youenc120-ux/smart-iv-drip-alert/SmartIVDrip.ino

/*
 * 智慧點滴注射預警系統 (Smart IV Drip Alert System)
 * 平台：ESP32 (Arduino core 3.x)
 *
 * 功能：
 *   - 上、下兩組非接觸式紅外線液位感測器，雙階段判斷
 *   - 第一階段（液位低於上位）：警示燈恆亮 + 提示音 + 推播
 *   - 第二階段（液位低於下位）：警示燈快閃 + 每秒警報 + 推播
 *   - 感測器狀態矛盾（上有液、下無液）判為感測器異常
 *   - 手機網頁即時監控（每秒更新）、遠端靜音、預估剩餘時間、更換紀錄
 *   - 網頁設定頁：床位名稱、Wi-Fi、網址、配對碼、點滴參數（免重新燒錄）
 *   - 固定網址：http://<裝置名稱>.local（mDNS）
 *   - 無線更新（OTA），密碼在 secrets.h 的 OTA_PASS：
 *       1. 網頁更新：瀏覽器開 http://<裝置>.local/update（帳號 admin），上傳編譯好的 .bin
 *       2. Arduino IDE「連接埠」選網路裝置（需允許防火牆，學校網路可能被擋）
 *   - 網頁推播：ESP32 直接加密並送到 Apple / Google 推播服務，不經第三方通知平台
 *
 * 接線：
 *   上位 TCRT5000 模組 AO -> GPIO32（VCC 接 3V3，DO 不接）
 *   下位 TCRT5000 模組 AO -> GPIO33（VCC 接 3V3，DO 不接）
 *     讀類比值，在設定頁「感測器校正」記錄有液 / 無液的讀值
 *   蜂鳴器模組 I/O -> GPIO25（VCC 接 3V3 或 5V，依模組規格）
 *   WS2812B 8 燈燈條 DIN -> 330Ω -> GPIO26（5V 接 VIN）
 *     第 1 顆：Wi-Fi 狀態；第 2–8 顆：液量燈條
 *
 * 需要程式庫：Adafruit NeoPixel（Arduino IDE 程式庫管理員搜尋安裝）
 */

#include <WiFi.h>
#include <WebServer.h>
#include <HTTPClient.h>
#include <WiFiClientSecure.h>
#include <ESPmDNS.h>
#include <ArduinoOTA.h>
#include <HTTPUpdateServer.h>
#include <Adafruit_NeoPixel.h>
#include <Preferences.h>
#include <time.h>
#include <vector>
#include "webpush.h"
#include "index_html.h"
#include "pair_html.h"
#include "settings_html.h"

// ===== 使用者設定 =====
// Wi-Fi 密碼與推播金鑰放在 secrets.h（不會上傳 GitHub）
// 第一次使用：把 secrets.example.h 複製一份改名為 secrets.h 再填入，並執行 make_vapid.ps1
// 之後床位名稱、Wi-Fi 等都可以在 http://<裝置>/settings 修改
#include "secrets.h"

const char* AP_SSID       = "IV-Monitor";  // 連不上 Wi-Fi 時自建熱點
const char* VAPID_SUBJECT = "https://github.com/youenc120-ux/smart-iv-drip-alert";  // 推播服務出問題時的聯絡方式

const unsigned long REPEAT_EMPTY_MS = 2UL * 60 * 1000;  // 第二階段未處理時每 2 分鐘再推播
const size_t MAX_SUBS    = 10;                           // 最多綁定幾支手機
const size_t MAX_HISTORY = 20;                           // 保留幾筆更換紀錄

// 感測器接 TCRT5000 模組的 AO（類比輸出），反射越強讀值越低。
// 有液 / 無液的讀值在設定頁「感測器校正」記錄；尚未校正時，暫時以中間值 2048 判斷，
// 並假設有液體時讀值較低（LIQUID_LEVEL = LOW）。
const int LIQUID_LEVEL = LOW;
const int MIN_CAL_GAP  = 150;  // 有液 / 無液讀值差距小於這個值，就提醒調整位置
const int MIN_TOUCH_GAP = 30;  // 鋁箔觸控模式的最小差距（實測後再調整）

const int PIN_SENSOR_UPPER = 32;
const int PIN_SENSOR_LOWER = 33;
const int PIN_BUZZER       = 25;
const int PIN_PIXELS       = 26;

// 蜂鳴器：HW-508 是被動式，要送 2–4kHz 方波才會發出清楚的聲音
// 換成主動式模組（通電就響）時改成 false，並依模組設定 BUZZER_ON（低電位觸發 = LOW）
const bool BUZZER_PASSIVE = true;
const int BUZZER_ON = LOW;

// WS2812B 燈條：第 0 顆顯示 Wi-Fi，其餘當液量燈條
const int NUM_PIXELS     = 8;
const int LED_BRIGHTNESS = 40;  // 0–255；8 顆全亮時電流不小，展示用 40 就夠亮
Adafruit_NeoPixel pixels(NUM_PIXELS, PIN_PIXELS, NEO_GRB + NEO_KHZ800);

const unsigned long DEBOUNCE_MS   = 1500;            // 液面晃動 / 氣泡濾除
const unsigned long MUTE_STAGE1_MS = 5UL * 60 * 1000; // 第一階段靜音 5 分鐘
const unsigned long MUTE_STAGE2_MS = 60UL * 1000;     // 第二階段最多靜音 1 分鐘

// ===== 狀態 =====
enum DripState { NORMAL, LOW_LEVEL, EMPTY, SENSOR_FAULT };
const char* STATE_KEY[]   = { "normal", "low", "empty", "fault" };
const char* STATE_TEXT[]  = { "液量充足", "第一階段：液量偏低", "第二階段：請立即更換", "感測器異常" };
const char* STATE_EMOJI[] = { "✅", "⚠️", "🚨", "❗" };

WebServer server(80);
HTTPUpdateServer httpUpdater;

DripState state = NORMAL;
unsigned long stateSince = 0;
unsigned long mutedUntil = 0;
bool apMode = false;
bool otaRunning = false;      // 無線更新中：暫停警報輸出
unsigned long restartAt = 0;  // 設定變更後延遲重新開機

// 型別需在第一個函式前定義，Arduino 自動產生的函式宣告才找得到

// 可在網頁上修改的設定（存在快閃記憶體）
struct Config {
  String bed = "301 病房 A 床";
  String host = "iv-monitor";  // 固定網址 http://iv-monitor.local
  String ssid, pass;           // 空白 = 使用 secrets.h
  String pin;                  // 配對碼，空白 = 不需要
  int mlBetween = 100;         // 上位到下位之間的液量（ml）
  int mlBelow = 50;            // 下位以下的剩餘液量（ml）
  int rateMlH = 0;             // 醫囑滴速（ml/小時），0 = 未設定
  // 感測器校正值（TCRT5000 的 AO 類比讀值 0–4095），-1 = 尚未校正
  int wetU = -1, dryU = -1;    // 上位：有液體 / 沒液體時的讀值
  int wetL = -1, dryL = -1;    // 下位：有液體 / 沒液體時的讀值
  // 感測方式：0 = TCRT5000 類比，1 = 相機節點（ESP32-CAM 回報液位百分比）
  int sensorMode = 0;          // 2 = 鋁箔觸控（GPIO32/33 是觸控腳位 T9/T8）
  String camHost = "iv-cam";   // 相機位址：主機名稱（不含 .local）或 IP
  int camUpper = 60;           // 液位低於這個百分比 = 上位沒液體（第一階段）
  int camLower = 20;           // 液位低於這個百分比 = 下位沒液體（第二階段）
} cfg;

// 去彈跳
struct Debounced {
  int pin;
  bool stable;        // true = 偵測到液體
  bool lastRaw;
  unsigned long changedAt;
};
Debounced upper = { PIN_SENSOR_UPPER, true, true, 0 };
Debounced lower = { PIN_SENSOR_LOWER, true, true, 0 };

// 推播訊息；welcome = 只送給剛綁定的手機（welcomeEndpoint 空白 = 全部手機）的測試通知
struct Notice { uint8_t state; char body[200]; bool welcome; };

// 一袋點滴的紀錄（Unix 秒，0 = 沒有發生或時間未知）
struct BagRecord { uint32_t startAt, lowAt, emptyAt, ackAt, doneAt; };

// 已綁定的手機（網頁伺服器與推播工作都會用到，以互斥鎖保護）
std::vector<webpush::Subscription> subs;
SemaphoreHandle_t subsLock;
String welcomeEndpoint;
Preferences prefs;
uint8_t vapidPriv[32];
bool vapidReady = false;

// 更換紀錄與滴速
BagRecord history[MAX_HISTORY];
size_t historyCount = 0;
BagRecord cur = { 0, 0, 0, 0, 0 };
uint32_t lastDoneAt = 0;          // 上一袋更換完成的時間 = 這一袋開始
unsigned long lowEnteredMs = 0;   // 進入第一階段的 millis，用來實測滴速
float bagRate = 0;                // 這一袋實測滴速（ml/小時）
float lastRate = 0;               // 上一袋實測滴速

// 配對碼嘗試次數限制
int pinFails = 0;
unsigned long pinLockUntil = 0;

// ===== 感測器（類比讀值 / 鋁箔觸控 + 校正）=====
// sensorMode 0：TCRT5000 的 AO 類比值（0–4095）
// sensorMode 2：鋁箔貼在點滴袋外，接 ESP32 觸控腳位；有水時電容變大，觸控讀值變小
//               （Arduino core 3.x 的 touchRead 數值較大，取 0–8000）
int rawU = 0, rawL = 0;  // 平滑後的讀值

bool touchMode() { return cfg.sensorMode == 2; }
int sensorMax() { return touchMode() ? 8000 : 4095; }
int minGap() { return touchMode() ? MIN_TOUCH_GAP : MIN_CAL_GAP; }

int readSensor(int pin) {
  long sum = 0;
  if (touchMode()) {
    for (int i = 0; i < 4; i++) sum += touchRead(pin);
    return min((long)sensorMax(), sum / 4);
  }
  for (int i = 0; i < 16; i++) sum += analogRead(pin);
  return sum / 16;
}

// 每 20ms 取樣一次，指數平滑濾掉雜訊
void sampleSensors(unsigned long now, bool force = false) {
  static unsigned long last = 0;
  if (!force && now - last < 20) return;
  last = now;
  int u = readSensor(PIN_SENSOR_UPPER), l = readSensor(PIN_SENSOR_LOWER);
  rawU = force ? u : (rawU * 3 + u) / 4;
  rawL = force ? l : (rawL * 3 + l) / 4;
}

// 依校正值判斷有沒有液體；中點加上遲滯，避免讀值在邊界附近時跳來跳去
bool judgeLiquid(int raw, int wet, int dry, bool prev) {
  if (wet < 0 || dry < 0) {  // 尚未校正：觸控模式有水時讀值較小；類比模式依 LIQUID_LEVEL
    wet = touchMode() || LIQUID_LEVEL == LOW ? 0 : sensorMax();
    dry = sensorMax() - wet;
  }
  int mid = (wet + dry) / 2, hys = abs(wet - dry) / 10;
  bool wetLow = wet < dry;
  if (prev) return wetLow ? raw < mid + hys : raw > mid - hys;
  return wetLow ? raw < mid - hys : raw > mid + hys;
}

// 相機節點回報的液位（由 camTask 更新）
volatile int camLevel = -1;
volatile unsigned long camOkAt = 0;

bool camFresh() { return camOkAt && millis() - camOkAt < 10000; }

bool readLiquid(const Debounced& s) {
  if (cfg.sensorMode == 1) {
    if (!camFresh()) {
      // 開機 30 秒內相機可能還沒連上，先當作正常；之後仍沒有資料 = 上有液、下無液 → 感測器異常
      return millis() < 30000 || s.pin == PIN_SENSOR_UPPER;
    }
    int thr = s.pin == PIN_SENSOR_UPPER ? cfg.camUpper : cfg.camLower;
    return s.lastRaw ? camLevel >= thr - 2 : camLevel >= thr;  // 2% 遲滯，避免在門檻附近跳動
  }
  return s.pin == PIN_SENSOR_UPPER ? judgeLiquid(rawU, cfg.wetU, cfg.dryU, s.lastRaw)
                                   : judgeLiquid(rawL, cfg.wetL, cfg.dryL, s.lastRaw);
}

void updateDebounce(Debounced& s, unsigned long now) {
  bool raw = readLiquid(s);
  if (raw != s.lastRaw) { s.lastRaw = raw; s.changedAt = now; }
  if (raw != s.stable && now - s.changedAt >= DEBOUNCE_MS) s.stable = raw;
}

DripState evaluate() {
  if (upper.stable && lower.stable)   return NORMAL;
  if (!upper.stable && lower.stable)  return LOW_LEVEL;
  if (!upper.stable && !lower.stable) return EMPTY;
  return SENSOR_FAULT;  // 上有液、下無液：物理上不合理
}

uint32_t nowEpoch() {
  time_t t = time(nullptr);
  return t >= 1700000000 ? (uint32_t)t : 0;
}

// ===== 輸出（燈條 / 蜂鳴器），非阻塞 =====
// 燈條：第 0 顆 = Wi-Fi（青＝已連線、藍＝熱點模式、白色閃＝斷線重連中）
//       第 1–7 顆 = 液量：充足 7 顆綠、偏低 4 顆黃、耗盡 2 顆紅快閃、異常全部紫色慢閃
// 靜音時改為恆亮不閃，現場一看就知道「已有人處理」
void updatePixels(unsigned long now, bool muted) {
  static uint32_t lastFrame[NUM_PIXELS];
  uint32_t frame[NUM_PIXELS];
  const int bar = NUM_PIXELS - 1;

  bool wifiOk = apMode || WiFi.status() == WL_CONNECTED;
  frame[0] = apMode ? pixels.Color(0, 0, 255)
           : wifiOk ? pixels.Color(0, 200, 200)
           : ((now / 400) % 2 ? pixels.Color(160, 160, 160) : 0);

  uint32_t color = 0;
  int lit = 0;
  bool blink = false;
  switch (state) {
    case NORMAL:       color = pixels.Color(0, 220, 0);   lit = bar;           break;
    case LOW_LEVEL:    color = pixels.Color(255, 140, 0); lit = (bar + 1) / 2; break;
    case EMPTY:        color = pixels.Color(255, 0, 0);   lit = 2; blink = (now / 250) % 2;  break;
    case SENSOR_FAULT: color = pixels.Color(150, 0, 255); lit = bar; blink = (now / 1000) % 2; break;
  }
  if (muted) blink = false;
  for (int i = 0; i < bar; i++) frame[i + 1] = (i < lit && !blink) ? color : 0;

  // 有變化才更新，避免頻繁送資料造成閃爍
  if (memcmp(frame, lastFrame, sizeof(frame)) == 0) return;
  memcpy(lastFrame, frame, sizeof(frame));
  for (int i = 0; i < NUM_PIXELS; i++) pixels.setPixelColor(i, frame[i]);
  pixels.show();
}

// 設定蜂鳴器頻率，0 = 安靜。只有改變時才動作
void setBuzzer(uint32_t freq) {
  static uint32_t current = UINT32_MAX;
  static bool attached = false;
  if (freq == current) return;
  current = freq;

  if (!BUZZER_PASSIVE) {
    digitalWrite(PIN_BUZZER, freq ? BUZZER_ON : !BUZZER_ON);
    return;
  }
  if (freq) {
    if (!attached) attached = ledcAttach(PIN_BUZZER, freq, 8);
    if (attached) ledcWriteTone(PIN_BUZZER, freq);  // 50% 方波
  } else {
    if (attached) { ledcDetach(PIN_BUZZER); attached = false; }
    pinMode(PIN_BUZZER, OUTPUT);
    digitalWrite(PIN_BUZZER, LOW);  // 安靜時保持低電位，蜂鳴器不通電
  }
}

void updateOutputs(unsigned long now) {
  bool muted = now < mutedUntil;
  unsigned long t = now - stateSince;
  uint32_t freq = 0;

  updatePixels(now, muted);

  switch (state) {
    case LOW_LEVEL: {
      // 「嗶、嗶」兩聲：進入時一次，之後每 30 秒提醒一次
      unsigned long c = t % 30000;
      if (c < 150 || (c >= 250 && c < 400)) freq = 2400;
      break;
    }
    case EMPTY: {
      // 每秒前 0.6 秒高低音交替（像救護車），連續警報
      unsigned long c = t % 1000;
      if (c < 600) freq = (c / 150) % 2 ? 2000 : 2700;
      break;
    }
    case SENSOR_FAULT:
      if (t % 3000 < 120) freq = 1500;  // 低沉短音，和液位警報區分
      break;
    default: break;
  }
  setBuzzer(muted ? 0 : freq);
}

String jsonEscape(const char* s) {
  String out;
  for (; *s; s++) {
    if (*s == '"' || *s == '\\') { out += '\\'; out += *s; }
    else if (*s == '\n') out += "\\n";
    else if ((uint8_t)*s >= 0x20) out += *s;
  }
  return out;
}
String jsonEscape(const String& s) { return jsonEscape(s.c_str()); }

// ===== 設定 =====
void loadConfig() {
  prefs.begin("cfg", true);
  cfg.bed       = prefs.getString("bed", cfg.bed);
  cfg.host      = prefs.getString("host", cfg.host);
  cfg.ssid      = prefs.getString("ssid", "");
  cfg.pass      = prefs.getString("pass", "");
  cfg.pin       = prefs.getString("pin", "");
  cfg.mlBetween = prefs.getInt("mlBetween", cfg.mlBetween);
  cfg.mlBelow   = prefs.getInt("mlBelow", cfg.mlBelow);
  cfg.rateMlH   = prefs.getInt("rate", cfg.rateMlH);
  cfg.wetU      = prefs.getInt("wetU", -1);
  cfg.dryU      = prefs.getInt("dryU", -1);
  cfg.wetL      = prefs.getInt("wetL", -1);
  cfg.dryL      = prefs.getInt("dryL", -1);
  cfg.sensorMode = prefs.getInt("mode", 0);
  cfg.camHost   = prefs.getString("camHost", cfg.camHost);
  cfg.camUpper  = prefs.getInt("camUpper", cfg.camUpper);
  cfg.camLower  = prefs.getInt("camLower", cfg.camLower);
  prefs.end();
}

void saveConfig() {
  prefs.begin("cfg", false);
  prefs.putString("bed", cfg.bed);
  prefs.putString("host", cfg.host);
  prefs.putString("ssid", cfg.ssid);
  prefs.putString("pass", cfg.pass);
  prefs.putString("pin", cfg.pin);
  prefs.putInt("mlBetween", cfg.mlBetween);
  prefs.putInt("mlBelow", cfg.mlBelow);
  prefs.putInt("rate", cfg.rateMlH);
  prefs.putInt("wetU", cfg.wetU);
  prefs.putInt("dryU", cfg.dryU);
  prefs.putInt("wetL", cfg.wetL);
  prefs.putInt("dryL", cfg.dryL);
  prefs.putInt("mode", cfg.sensorMode);
  prefs.putString("camHost", cfg.camHost);
  prefs.putInt("camUpper", cfg.camUpper);
  prefs.putInt("camLower", cfg.camLower);
  prefs.end();
}

const char* wifiSsid() { return cfg.ssid.length() ? cfg.ssid.c_str() : WIFI_SSID; }
const char* wifiPass() { return cfg.ssid.length() ? cfg.pass.c_str() : WIFI_PASS; }

// ===== 更換紀錄 =====
void loadHistory() {
  prefs.begin("hist", true);
  historyCount = prefs.getBytes("h", history, sizeof(history)) / sizeof(BagRecord);
  lastDoneAt = prefs.getUInt("last", 0);
  lastRate = prefs.getFloat("rate", 0);
  prefs.end();
}

void saveHistory() {
  prefs.begin("hist", false);
  prefs.putBytes("h", history, historyCount * sizeof(BagRecord));
  prefs.putUInt("last", lastDoneAt);
  prefs.putFloat("rate", lastRate);
  prefs.end();
}

// 狀態改變時更新這一袋的紀錄與實測滴速
void trackBag(DripState next, DripState prev, unsigned long now) {
  if (next == LOW_LEVEL && prev == NORMAL) {
    cur = { lastDoneAt, nowEpoch(), 0, 0, 0 };
    lowEnteredMs = now;
    bagRate = 0;
  } else if (next == EMPTY && prev != SENSOR_FAULT) {
    if (!cur.lowAt && !cur.emptyAt) cur.startAt = lastDoneAt;
    cur.emptyAt = nowEpoch();
    // 上位到下位的液量 ÷ 花費時間 = 實測滴速；過快或過慢視為誤判
    if (prev == LOW_LEVEL && lowEnteredMs) {
      float hours = (now - lowEnteredMs) / 3600000.0f;
      float r = cfg.mlBetween / hours;
      if (r >= 5 && r <= 2000) { bagRate = r; lastRate = r; }
    }
  } else if (next == NORMAL && (prev == LOW_LEVEL || prev == EMPTY)) {
    cur.doneAt = nowEpoch();
    if (historyCount == MAX_HISTORY) {
      memmove(history, history + 1, sizeof(BagRecord) * (MAX_HISTORY - 1));
      historyCount--;
    }
    history[historyCount++] = cur;
    lastDoneAt = cur.doneAt;
    cur = { 0, 0, 0, 0, 0 };
    lowEnteredMs = 0;
    bagRate = 0;
    saveHistory();
  }
}

// 預估剩餘時間（秒），-1 = 無法預估。src 回傳滴速來源
float currentRate(const char** src) {
  if (state == EMPTY && bagRate > 0) { *src = "measured"; return bagRate; }
  if (cfg.rateMlH > 0) { *src = "set"; return cfg.rateMlH; }
  if (lastRate > 0) { *src = "last"; return lastRate; }
  *src = "";
  return 0;
}

long etaSeconds(unsigned long now, const char** src) {
  float r = currentRate(src);
  if (r <= 0) return -1;
  float hours = (now - stateSince) / 3600000.0f;
  float remaining;
  if (state == LOW_LEVEL)  remaining = max(0.0f, cfg.mlBetween - r * hours) + cfg.mlBelow;
  else if (state == EMPTY) remaining = max(0.0f, cfg.mlBelow - r * hours);
  else return -1;
  return (long)(remaining / r * 3600);
}

String durationText(long s) {
  if (s < 60) return "不到 1 分鐘";
  long m = (s + 30) / 60;
  if (m < 60) return "約 " + String(m) + " 分鐘";
  return "約 " + String(m / 60) + " 小時 " + String(m % 60) + " 分";
}

// ===== 已綁定手機的儲存（存在快閃記憶體，斷電不會消失）=====
void loadSubs() {
  prefs.begin("push", true);
  for (size_t i = 0; i < MAX_SUBS; i++) {
    String v = prefs.getString(("s" + String(i)).c_str(), "");
    int a = v.indexOf('\n'), b = v.indexOf('\n', a + 1);
    if (a > 0 && b > a) subs.push_back({ v.substring(0, a), v.substring(a + 1, b), v.substring(b + 1) });
  }
  prefs.end();
  Serial.printf("[推播] 已綁定 %u 支手機\n", (unsigned)subs.size());
}

// 呼叫前須持有 subsLock
void saveSubs() {
  prefs.begin("push", false);
  prefs.clear();
  for (size_t i = 0; i < subs.size(); i++)
    prefs.putString(("s" + String(i)).c_str(), subs[i].endpoint + "\n" + subs[i].p256dh + "\n" + subs[i].auth);
  prefs.end();
}

void removeSub(const String& endpoint) {
  xSemaphoreTake(subsLock, portMAX_DELAY);
  for (size_t i = 0; i < subs.size(); i++) {
    if (subs[i].endpoint == endpoint) { subs.erase(subs.begin() + i); saveSubs(); break; }
  }
  xSemaphoreGive(subsLock);
}

// 配對碼檢查：設定了配對碼才需要；連續錯 5 次鎖 60 秒
// 回傳 nullptr = 通過，否則為錯誤訊息
const char* checkPin(const String& given) {
  if (!cfg.pin.length()) return nullptr;
  if (millis() < pinLockUntil) return "錯誤次數太多，請 1 分鐘後再試";
  if (given == cfg.pin) { pinFails = 0; return nullptr; }
  if (++pinFails >= 5) { pinFails = 0; pinLockUntil = millis() + 60000; }
  return given.length() ? "配對碼錯誤" : "需要配對碼";
}

// ===== 網頁 =====
// 監控頁在 index_html.h（由 phone.html 產生），配對頁在 pair_html.h，設定頁在 settings_html.h

void handleRoot()     { server.send_P(200, "text/html; charset=utf-8", INDEX_HTML); }
void handlePair()     { server.send_P(200, "text/html; charset=utf-8", PAIR_HTML); }
void handleSettings() { server.send_P(200, "text/html; charset=utf-8", SETTINGS_HTML); }

void sendJson(const String& json) {
  server.sendHeader("Access-Control-Allow-Origin", "*");
  server.send(200, "application/json; charset=utf-8", json);
}

void handleStatus() {
  unsigned long now = millis();
  bool muted = now < mutedUntil;
  const char* src;
  long eta = etaSeconds(now, &src);
  float rate = currentRate(&src);
  String json = "{";
  json += "\"bed\":\"" + jsonEscape(cfg.bed) + "\",";
  json += "\"state\":\"" + String(STATE_KEY[state]) + "\",";
  json += "\"text\":\"" + String(STATE_TEXT[state]) + "\",";
  json += "\"upper\":" + String(upper.stable ? "true" : "false") + ",";
  json += "\"lower\":" + String(lower.stable ? "true" : "false") + ",";
  json += "\"muted\":" + String(muted ? "true" : "false") + ",";
  json += "\"muteLeft\":" + String(muted ? (mutedUntil - now) / 1000 : 0) + ",";
  json += "\"since\":" + String((now - stateSince) / 1000) + ",";
  json += "\"eta\":" + String(eta) + ",";
  json += "\"rate\":" + String((int)(rate + 0.5f)) + ",";
  json += "\"rateSrc\":\"" + String(src) + "\",";
  json += "\"push\":" + String((unsigned)subs.size()) + ",";
  json += "\"host\":\"" + jsonEscape(cfg.host) + "\",";
  json += "\"level\":" + String(cfg.sensorMode == 1 && camFresh() ? camLevel : -1) + ",";
  json += "\"ap\":" + String(apMode ? "true" : "false") + ",";
  json += "\"rssi\":" + String(apMode ? 0 : WiFi.RSSI());
  json += "}";
  sendJson(json);
}

void handleHistory() {
  String json = "{\"now\":" + String(nowEpoch()) + ",\"items\":[";
  for (size_t i = historyCount; i-- > 0;) {
    const BagRecord& r = history[i];
    json += "{\"s\":" + String(r.startAt) + ",\"l\":" + String(r.lowAt) + ",\"e\":" + String(r.emptyAt) +
            ",\"a\":" + String(r.ackAt) + ",\"d\":" + String(r.doneAt) + "}";
    if (i) json += ",";
  }
  sendJson(json + "]}");
}

void handleMute() {
  // 第二階段只允許短暫靜音，避免警報被長時間關閉
  unsigned long dur = (state == EMPTY) ? MUTE_STAGE2_MS : MUTE_STAGE1_MS;
  if (state != NORMAL) {
    mutedUntil = millis() + dur;
    if ((state == LOW_LEVEL || state == EMPTY) && !cur.ackAt) cur.ackAt = nowEpoch();  // 記錄確認時間
  }
  server.send(200, "text/plain", "ok");
}

void replyJson(bool ok, const char* error, bool needPin = false) {
  String j = String("{\"ok\":") + (ok ? "true" : "false") + ",\"bed\":\"" + jsonEscape(cfg.bed) + "\"";
  if (error) j += String(",\"error\":\"") + error + "\"";
  if (needPin) j += ",\"needPin\":true";
  sendJson(j + "}");
}

void queueNotice(uint8_t st, const char* body, bool welcome = false);

void handleSubscribe() {
  String e = server.arg("endpoint"), k = server.arg("p256dh"), a = server.arg("auth");
  uint8_t buf[70];
  if (!vapidReady) return replyJson(false, "裝置尚未設定推播金鑰（請執行 make_vapid.ps1 後重新燒錄）");
  if (const char* err = checkPin(server.arg("pin"))) return replyJson(false, err, true);
  if (e.length() > 700 || !webpush::endpointAllowed(e)) return replyJson(false, "不支援這個瀏覽器的推播服務");
  if (webpush::b64urlDecode(k, buf, sizeof(buf)) != 65 || webpush::b64urlDecode(a, buf, sizeof(buf)) != 16)
    return replyJson(false, "訂閱資料格式錯誤");

  xSemaphoreTake(subsLock, portMAX_DELAY);
  for (size_t i = 0; i < subs.size(); i++) {
    if (subs[i].endpoint == e) { subs.erase(subs.begin() + i); break; }
  }
  if (subs.size() >= MAX_SUBS) subs.erase(subs.begin());  // 滿了就移除最舊的
  subs.push_back({ e, k, a });
  saveSubs();
  welcomeEndpoint = e;
  xSemaphoreGive(subsLock);

  Serial.printf("[推播] 新增手機，目前 %u 支\n", (unsigned)subs.size());
  queueNotice(state, "已連結這支手機，之後點滴警報會推播到這裡。", true);
  replyJson(true, nullptr);
}

void handleUnsubscribe() {
  removeSub(server.arg("endpoint"));
  replyJson(true, nullptr);
}

// 傳一則測試推播給所有已綁定的手機
void handlePushTest() {
  if (subs.empty()) return replyJson(false, "還沒有綁定任何手機");
  xSemaphoreTake(subsLock, portMAX_DELAY);
  welcomeEndpoint = "";  // 空字串 = 所有手機
  xSemaphoreGive(subsLock);
  queueNotice(state, "這是測試推播，收到代表推播功能正常。", true);
  replyJson(true, nullptr);
}

// 目前設定（不含密碼與配對碼本身）
void handleConfigGet() {
  String json = "{";
  json += "\"bed\":\"" + jsonEscape(cfg.bed) + "\",";
  json += "\"host\":\"" + jsonEscape(cfg.host) + "\",";
  json += "\"ssid\":\"" + jsonEscape(wifiSsid()) + "\",";
  json += "\"pinSet\":" + String(cfg.pin.length() ? "true" : "false") + ",";
  json += "\"mlBetween\":" + String(cfg.mlBetween) + ",";
  json += "\"mlBelow\":" + String(cfg.mlBelow) + ",";
  json += "\"rate\":" + String(cfg.rateMlH) + ",";
  json += "\"lastRate\":" + String((int)(lastRate + 0.5f)) + ",";
  json += "\"sensorMode\":" + String(cfg.sensorMode) + ",";
  json += "\"camHost\":\"" + jsonEscape(cfg.camHost) + "\",";
  json += "\"camUpper\":" + String(cfg.camUpper) + ",";
  json += "\"camLower\":" + String(cfg.camLower) + ",";
  json += "\"ip\":\"" + (apMode ? WiFi.softAPIP() : WiFi.localIP()).toString() + "\",";
  json += "\"ap\":" + String(apMode ? "true" : "false");
  sendJson(json + "}");
}

bool validHost(const String& h) {
  if (h.length() < 1 || h.length() > 30 || h[0] == '-' || h[h.length() - 1] == '-') return false;
  for (char c : h) if (!(isdigit(c) || (c >= 'a' && c <= 'z') || c == '-')) return false;
  return true;
}

void handleConfigPost() {
  if (const char* err = checkPin(server.arg("auth"))) return replyJson(false, err, true);

  String bed = server.arg("bed"), host = server.arg("host"), ssid = server.arg("ssid"), pin = server.arg("pin");
  bed.trim(); host.trim(); host.toLowerCase(); ssid.trim(); pin.trim();
  int mlBetween = server.arg("mlBetween").toInt(), mlBelow = server.arg("mlBelow").toInt();
  int rate = server.arg("rate").toInt();

  if (!bed.length() || bed.length() > 60) return replyJson(false, "床位名稱請輸入 1–20 個字");
  if (!validHost(host)) return replyJson(false, "裝置網址只能用小寫英文、數字和 -");
  if (ssid.length() > 32) return replyJson(false, "Wi-Fi 名稱太長");
  if (pin.length() && (pin.length() < 4 || pin.length() > 8)) return replyJson(false, "配對碼請設 4–8 位數字");
  for (char c : pin) if (!isdigit(c)) return replyJson(false, "配對碼只能用數字");
  if (mlBetween < 1 || mlBetween > 2000 || mlBelow < 1 || mlBelow > 2000) return replyJson(false, "液量請輸入 1–2000 ml");
  if (rate < 0 || rate > 2000) return replyJson(false, "滴速請輸入 0–2000 ml/小時");
  int mode = server.arg("sensorMode").toInt(), camUpper = server.arg("camUpper").toInt(), camLower = server.arg("camLower").toInt();
  String camHost = server.arg("camHost");
  camHost.trim(); camHost.toLowerCase(); camHost.replace(".local", "");
  if (mode == 1) {
    if (!camHost.length() || camHost.length() > 40) return replyJson(false, "請輸入相機位址");
    if (camLower < 1 || camUpper > 99 || camUpper <= camLower) return replyJson(false, "百分比請設 1–99，且第一階段要大於第二階段");
  }

  bool netChanged = host != cfg.host || ssid != String(wifiSsid()) || server.arg("pass").length() > 0;
  cfg.bed = bed;
  cfg.host = host;
  if (ssid != String(wifiSsid()) || server.arg("pass").length()) {
    cfg.ssid = ssid;
    if (server.arg("pass").length()) cfg.pass = server.arg("pass");
  }
  if (server.arg("clearPin") == "1") cfg.pin = "";
  else if (pin.length()) cfg.pin = pin;
  cfg.mlBetween = mlBetween;
  cfg.mlBelow = mlBelow;
  cfg.rateMlH = rate;
  int newMode = mode == 1 || mode == 2 ? mode : 0;
  // 類比與觸控的讀值範圍不同，切換時舊的校正值作廢
  if ((newMode == 2) != (cfg.sensorMode == 2) && newMode != 1) cfg.wetU = cfg.dryU = cfg.wetL = cfg.dryL = -1;
  cfg.sensorMode = newMode;
  if (mode == 1) { cfg.camHost = camHost; cfg.camUpper = camUpper; cfg.camLower = camLower; }
  saveConfig();
  Serial.println("[設定] 已儲存");

  if (netChanged) restartAt = millis() + 1500;  // 回應送出後再重新開機
  sendJson(String("{\"ok\":true,\"restart\":") + (netChanged ? "true" : "false") + "}");
}

// 感測器即時讀值與校正狀態（設定頁每 0.5 秒讀一次）
void handleRaw() {
  String json = "{\"u\":" + String(rawU) + ",\"l\":" + String(rawL) +
                ",\"uLiq\":" + String(upper.lastRaw ? "true" : "false") +
                ",\"lLiq\":" + String(lower.lastRaw ? "true" : "false") +
                ",\"wetU\":" + String(cfg.wetU) + ",\"dryU\":" + String(cfg.dryU) +
                ",\"wetL\":" + String(cfg.wetL) + ",\"dryL\":" + String(cfg.dryL) +
                ",\"minGap\":" + String(minGap()) + ",\"max\":" + String(sensorMax()) +
                ",\"mode\":" + String(cfg.sensorMode) +
                ",\"level\":" + String(camFresh() ? camLevel : -1) + "}";
  sendJson(json);
}

// 記錄目前讀值為「有液體」或「沒液體」；target = both / upper / lower
void handleCalibrate() {
  if (const char* err = checkPin(server.arg("auth"))) return replyJson(false, err, true);
  String which = server.arg("which"), target = server.arg("target");
  if (which != "wet" && which != "dry") return replyJson(false, "參數錯誤");
  bool doU = target != "lower", doL = target != "upper";
  if (which == "wet") {
    if (doU) cfg.wetU = rawU;
    if (doL) cfg.wetL = rawL;
  } else {
    if (doU) cfg.dryU = rawU;
    if (doL) cfg.dryL = rawL;
  }
  if (server.arg("reset") == "1") cfg.wetU = cfg.dryU = cfg.wetL = cfg.dryL = -1;
  saveConfig();
  Serial.printf("[校正] 上位 有液=%d 無液=%d；下位 有液=%d 無液=%d\n", cfg.wetU, cfg.dryU, cfg.wetL, cfg.dryL);
  replyJson(true, nullptr);
}

// 非同步掃描附近 Wi-Fi，避免卡住警報
void handleScan() {
  int n = WiFi.scanComplete();
  if (n == WIFI_SCAN_FAILED) { WiFi.scanNetworks(true); return sendJson("{\"scanning\":true}"); }
  if (n == WIFI_SCAN_RUNNING) return sendJson("{\"scanning\":true}");
  String json = "{\"scanning\":false,\"list\":[";
  bool first = true;
  for (int i = 0; i < n; i++) {
    String s = WiFi.SSID(i);
    if (!s.length()) continue;
    bool dup = false;
    for (int j = 0; j < i; j++) if (WiFi.SSID(j) == s) { dup = true; break; }
    if (dup) continue;
    if (!first) json += ",";
    first = false;
    json += "{\"ssid\":\"" + jsonEscape(s) + "\",\"rssi\":" + String(WiFi.RSSI(i)) +
            ",\"lock\":" + String(WiFi.encryptionType(i) != WIFI_AUTH_OPEN ? "true" : "false") + "}";
  }
  WiFi.scanDelete();
  sendJson(json + "]}");
}

// ===== 推播通知 =====
// HTTPS 連線要 1–3 秒，放在獨立工作執行，蜂鳴器與網頁才不會卡住
QueueHandle_t noticeQueue;
unsigned long lastEmptyNotice = 0;

bool postJson(const char* service, const String& url, const String& json) {
  WiFiClientSecure client;
  client.setInsecure();  // 原型簡化：不驗證憑證
  HTTPClient http;
  http.setTimeout(8000);
  if (!http.begin(client, url)) return false;
  http.addHeader("Content-Type", "application/json");
  int code = http.POST(json);
  http.end();
  Serial.printf("[通知] %s 回應 %d\n", service, code);  // 不印網址，避免 Token 外洩
  return code >= 200 && code < 300;
}

void sendWebPush(const Notice& n) {
  if (!vapidReady) return;
  std::vector<webpush::Subscription> targets;
  xSemaphoreTake(subsLock, portMAX_DELAY);
  for (auto& s : subs)
    if (!n.welcome || welcomeEndpoint.isEmpty() || s.endpoint == welcomeEndpoint) targets.push_back(s);
  xSemaphoreGive(subsLock);
  if (targets.empty()) return;

  // 手機上的推播網頁依照這些欄位顯示通知與紀錄
  String payload = "{\"bed\":\"" + jsonEscape(cfg.bed) + "\",\"state\":\"" +
                   (n.welcome ? "test" : STATE_KEY[n.state]) + "\",\"body\":\"" + jsonEscape(n.body) +
                   "\",\"url\":\"http://" + WiFi.localIP().toString() + "/\",\"t\":" +
                   String((unsigned long)time(nullptr)) + "}";
  for (auto& s : targets) {
    int code = webpush::send(s, payload, vapidPriv, VAPID_PUBLIC, VAPID_SUBJECT);
    Serial.printf("[推播] 回應 %d\n", code);
    if (code == 404 || code == 410) removeSub(s.endpoint);  // 手機已取消訂閱
  }
}

void sendTelegram(const Notice& n) {
  if (n.welcome || !strlen(TG_TOKEN) || !strlen(TG_CHAT_ID)) return;
  String text = String(STATE_EMOJI[n.state]) + " " + cfg.bed + "\n" + n.body;
  String j = "{\"chat_id\":\"" + jsonEscape(TG_CHAT_ID) + "\",\"text\":\"" + jsonEscape(text) + "\"}";
  String url = String("https://api.telegram.org/bot") + TG_TOKEN + "/sendMessage";
  for (int i = 0; i < 2 && !postJson("Telegram", url, j); i++) delay(3000);
}

// 公曆日期換算成 1970-01-01 起算的天數，用來把 HTTP Date 標頭轉成 Unix 時間
long daysFromCivil(int y, int m, int d) {
  y -= m <= 2;
  long era = (y >= 0 ? y : y - 399) / 400;
  long yoe = y - era * 400;
  long doy = (153 * (m + (m > 2 ? -3 : 9)) + 2) / 5 + d - 1;
  long doe = yoe * 365 + yoe / 4 - yoe / 100 + doy;
  return era * 146097 + doe - 719468;
}

// 推播簽章需要正確時間。先等 NTP；學校或公司網路常擋 NTP，就改用 HTTPS 回應的 Date 標頭校時
bool ensureTime() {
  for (int i = 0; i < 20 && time(nullptr) < 1700000000; i++) delay(500);
  if (time(nullptr) >= 1700000000) return true;

  WiFiClientSecure client;
  client.setInsecure();
  HTTPClient http;
  const char* keys[] = { "Date" };
  if (!http.begin(client, "https://www.google.com/generate_204")) return false;
  http.collectHeaders(keys, 1);
  http.GET();
  String date = http.header("Date");  // 例如 "Wed, 29 Oct 2026 08:12:33 GMT"
  http.end();

  int day, year, hh, mm, ss;
  char mon[4] = {0};
  if (sscanf(date.c_str(), "%*3s, %d %3s %d %d:%d:%d", &day, mon, &year, &hh, &mm, &ss) != 6) {
    Serial.println("[時間] 校時失敗，無法發送推播");
    return false;
  }
  const char* months = "JanFebMarAprMayJunJulAugSepOctNovDec";
  const char* p = strstr(months, mon);
  if (!p) return false;
  int month = (p - months) / 3 + 1;
  struct timeval tv = { (time_t)(daysFromCivil(year, month, day) * 86400L + hh * 3600L + mm * 60L + ss), 0 };
  settimeofday(&tv, nullptr);
  Serial.println("[時間] NTP 無回應，已改用網站時間校時");
  return true;
}

void notifyTask(void*) {
  if (!apMode) ensureTime();  // 開機先校時，更換紀錄才有正確時間
  Notice n;
  for (;;) {
    if (xQueueReceive(noticeQueue, &n, portMAX_DELAY) != pdTRUE) continue;
    if (WiFi.status() != WL_CONNECTED) {
      Serial.println("[通知] 未連上網際網路（熱點模式或斷線），略過推播");
      continue;
    }
    if (!ensureTime()) continue;
    sendWebPush(n);
    sendTelegram(n);
  }
}

void queueNotice(uint8_t st, const char* body, bool welcome) {
  if (subs.empty() && !strlen(TG_TOKEN)) return;
  Notice n;
  n.state = st;
  n.welcome = welcome;
  snprintf(n.body, sizeof(n.body), "%s", body);
  xQueueSend(noticeQueue, &n, 0);  // 佇列滿就丟棄，不阻塞主迴圈
}

// 狀態已更新後呼叫，訊息會附上預估剩餘時間
void announce(DripState next, DripState prev, unsigned long now) {
  const char* src;
  long eta = etaSeconds(now, &src);
  String msg;
  switch (next) {
    case LOW_LEVEL:
      if (prev == EMPTY) return;  // 液位不會自己變多，多半是晃動，不重複通知
      msg = "第一階段：液量偏低，請準備更換點滴。";
      if (eta >= 0) msg += "預計" + durationText(eta) + "後耗盡。";
      break;
    case EMPTY:
      msg = "第二階段：點滴即將耗盡，請立即更換！";
      if (eta >= 0) msg += "預計" + durationText(eta) + "後滴完。";
      lastEmptyNotice = now;
      break;
    case SENSOR_FAULT:
      msg = "感測器讀值異常，請檢查安裝位置。";
      break;
    case NORMAL:
      if (prev == NORMAL) return;
      msg = "液位已恢復正常（已更換或已排除）。";
      break;
  }
  queueNotice(next, msg.c_str());
}

// ===== 相機節點 =====
// 每秒向 ESP32-CAM 讀取液位；放在獨立工作，相機沒回應時不會卡住警報
void camTask(void*) {
  IPAddress cached;
  int failures = 0;
  for (;;) {
    delay(1000);
    if (cfg.sensorMode != 1 || apMode || WiFi.status() != WL_CONNECTED) continue;
    String host = cfg.camHost;
    host.replace(".local", "");
    IPAddress target;
    if (!target.fromString(host)) {
      // 主機名稱：用 mDNS 查 IP，失敗幾次後重新查（相機重開機 IP 可能改變）
      if (cached == IPAddress() || failures >= 3) { cached = MDNS.queryHost(host.c_str(), 1500); failures = 0; }
      target = cached;
    }
    if (target == IPAddress()) { failures++; continue; }

    WiFiClient client;
    HTTPClient http;
    http.setTimeout(1500);
    int lv = -1;
    if (http.begin(client, "http://" + target.toString() + "/level") && http.GET() == 200) {
      String body = http.getString();
      int i = body.indexOf("\"level\":");
      if (i >= 0) lv = body.substring(i + 8).toInt();
    }
    http.end();
    if (lv >= 0) { camLevel = lv; camOkAt = millis(); failures = 0; }
    else failures++;
  }
}

// ===== 無線更新（OTA）=====
// 更新期間停止蜂鳴器，燈條以藍色顯示進度；完成後自動重新開機
void setupOTA() {
  ArduinoOTA.setHostname(cfg.host.c_str());
  ArduinoOTA.setPassword(OTA_PASS);
  ArduinoOTA.setMdnsEnabled(false);  // mDNS 已在 setupWiFi 啟動
  ArduinoOTA.onStart([]() {
    otaRunning = true;
    setBuzzer(0);
    pixels.clear();
    pixels.show();
    Serial.println("[更新] 開始無線更新");
  });
  ArduinoOTA.onProgress([](unsigned int done, unsigned int total) {
    int lit = total ? (int)((uint64_t)done * NUM_PIXELS / total) : 0;
    for (int i = 0; i < NUM_PIXELS; i++) pixels.setPixelColor(i, i < lit ? pixels.Color(0, 80, 255) : 0);
    pixels.show();
  });
  ArduinoOTA.onEnd([]() { Serial.println("[更新] 完成，重新開機"); });
  ArduinoOTA.onError([](ota_error_t e) {
    otaRunning = false;
    Serial.printf("[更新] 失敗（錯誤 %u），繼續執行原程式\n", e);
  });
  ArduinoOTA.begin();
}

void setupWiFi() {
  WiFi.mode(WIFI_STA);
  WiFi.setHostname(cfg.host.c_str());
  WiFi.begin(wifiSsid(), wifiPass());
  Serial.printf("連線 Wi-Fi「%s」", wifiSsid());
  unsigned long start = millis();
  while (WiFi.status() != WL_CONNECTED && millis() - start < 15000) {
    delay(300);
    Serial.print(".");
  }
  if (WiFi.status() == WL_CONNECTED) {
    configTime(0, 0, "pool.ntp.org", "time.google.com");  // 推播簽章與紀錄需要正確時間
    if (MDNS.begin(cfg.host.c_str())) {
      MDNS.addService("http", "tcp", 80);
      MDNS.enableArduino(3232, true);  // 讓 Arduino IDE 找到這台裝置做無線更新
    }
    setupOTA();
    Serial.printf("\n已連線，手機開啟 http://%s.local 或 http://%s\n", cfg.host.c_str(),
                  WiFi.localIP().toString().c_str());
  } else {
    // 熱點模式同時保留 STA，設定頁才能掃描附近的 Wi-Fi
    apMode = true;
    WiFi.disconnect(true);
    WiFi.mode(WIFI_AP_STA);
    WiFi.softAP(AP_SSID, AP_PASS);
    Serial.printf("\n連不上 Wi-Fi，改用熱點 %s，手機開啟 http://%s/settings 設定網路\n", AP_SSID,
                  WiFi.softAPIP().toString().c_str());
  }
}

void setup() {
  Serial.begin(115200);
  pinMode(PIN_SENSOR_UPPER, INPUT);
  pinMode(PIN_SENSOR_LOWER, INPUT);
  pinMode(PIN_BUZZER, OUTPUT);
  setBuzzer(0);  // 先設成不響，避免開機瞬間亂叫
  pixels.begin();
  pixels.setBrightness(LED_BRIGHTNESS);

  // 開機自檢：燈條彩虹掃過一次 + 蜂鳴器短響
  for (int i = 0; i < NUM_PIXELS; i++) {
    pixels.setPixelColor(i, pixels.ColorHSV(i * 65536L / NUM_PIXELS));
    pixels.show();
    delay(50);
  }
  setBuzzer(2700); delay(150); setBuzzer(0);
  delay(300);
  pixels.clear();
  pixels.show();

  loadConfig();
  loadHistory();

  analogReadResolution(12);
  sampleSensors(millis(), true);
  upper.stable = upper.lastRaw = readLiquid(upper);
  lower.stable = lower.lastRaw = readLiquid(lower);
  state = evaluate();
  stateSince = millis();
  if (state == LOW_LEVEL || state == EMPTY) cur = { lastDoneAt, 0, 0, 0, 0 };

  uint8_t keyBuf[40];
  vapidReady = webpush::b64urlDecode(VAPID_PRIVATE, keyBuf, sizeof(keyBuf)) == 32;
  if (vapidReady) memcpy(vapidPriv, keyBuf, 32);
  else Serial.println("[推播] 未設定 VAPID 金鑰，請執行 make_vapid.ps1 後重新燒錄");
  subsLock = xSemaphoreCreateMutex();
  loadSubs();

  setupWiFi();
  noticeQueue = xQueueCreate(8, sizeof(Notice));
  xTaskCreate(notifyTask, "notify", 16384, nullptr, 1, nullptr);  // 加密 + TLS 需要較大堆疊
  xTaskCreate(camTask, "cam", 6144, nullptr, 1, nullptr);
  if (state != NORMAL) announce(state, NORMAL, millis());  // 開機時就已偏低也要通知

  server.on("/", handleRoot);
  server.on("/status", handleStatus);
  server.on("/history", handleHistory);
  server.on("/mute", HTTP_POST, handleMute);
  server.on("/pair", handlePair);
  server.on("/subscribe", HTTP_POST, handleSubscribe);
  server.on("/unsubscribe", HTTP_POST, handleUnsubscribe);
  server.on("/pushtest", HTTP_POST, handlePushTest);
  server.on("/settings", handleSettings);
  server.on("/config", HTTP_GET, handleConfigGet);
  server.on("/config", HTTP_POST, handleConfigPost);
  server.on("/scan", handleScan);
  server.on("/raw", handleRaw);
  server.on("/calibrate", HTTP_POST, handleCalibrate);
  httpUpdater.setup(&server, "/update", "admin", OTA_PASS);  // 網頁無線更新
  server.begin();
}

void loop() {
  unsigned long now = millis();
  if (!apMode) ArduinoOTA.handle();
  if (otaRunning) return;  // 更新中只處理 OTA，避免寫入快閃記憶體時被打斷
  server.handleClient();

  sampleSensors(now);
  updateDebounce(upper, now);
  updateDebounce(lower, now);

  DripState next = evaluate();
  if (next != state) {
    DripState prev = state;
    // 狀態升級（更嚴重）時取消靜音，確保新警報一定響
    if (next > prev) mutedUntil = 0;
    Serial.printf("[狀態] %s -> %s\n", STATE_TEXT[prev], STATE_TEXT[next]);
    state = next;
    stateSince = now;
    trackBag(next, prev, now);
    announce(next, prev, now);
  }

  // 第二階段一直沒人處理（也沒按靜音）就重複推播
  if (state == EMPTY && now >= mutedUntil && now - lastEmptyNotice >= REPEAT_EMPTY_MS) {
    String msg = "點滴耗盡已持續" + durationText((now - stateSince) / 1000) + "，仍未處理！";
    queueNotice(EMPTY, msg.c_str());
    lastEmptyNotice = now;
  }

  updateOutputs(now);

  // 每秒印出感測器讀值，方便對照設定頁的校正
  static unsigned long lastPrint = 0;
  if (now - lastPrint > 1000) {
    lastPrint = now;
    Serial.printf("上位=%d(%s) 下位=%d(%s) 狀態=%s\n", rawU, upper.stable ? "有液" : "無液",
                  rawL, lower.stable ? "有液" : "無液", STATE_TEXT[state]);
  }

  // Wi-Fi 斷線自動重連
  static unsigned long lastCheck = 0;
  if (!apMode && now - lastCheck > 10000) {
    lastCheck = now;
    if (WiFi.status() != WL_CONNECTED) WiFi.reconnect();
  }

  if (restartAt && now >= restartAt) ESP.restart();
}
