youenc120-ux/smart-iv-drip-alert/(commit log)

2026-10-27 Initial commit: smart IV drip alert system
    ESP32 firmware with dual-level IR sensing, buzzer/LED alerts,
    mobile web monitor, and ntfy/Telegram push notifications.
    [SmartIVDrip.ino, secrets.example.h]
2026-10-27 Add cross-platform Flutter monitoring app
    Multi-bed monitoring, system notifications, alarm-volume ringing for
    stage 2, one-tap acknowledge/mute, demo mode, and a setup script that
    applies the Android/iOS permissions needed for local HTTP.
2026-10-27 Replace ntfy with self-hosted Web Push
    ESP32 now encrypts (RFC 8291) and VAPID-signs (RFC 8292) push messages
    itself and sends them straight to the browser push services. Phones
    subscribe through a PWA on GitHub Pages and hand the subscription to
    the device via its /pair page. Subscriptions persist in NVS.
    [SmartIVDrip.ino, secrets.example.h, webpush.h]
2026-10-27 Push app: fix dark-mode contrast and device row layout
2026-10-29 Add test push endpoint, HTTP Date time fallback, push error logging
    [SmartIVDrip.ino, webpush.h]
2026-10-29 Redesign device monitor page
    Animated IV bag with sensor markers and drip chamber, stage bar,
    tinted status card, mute countdown, timeline log, signal indicator.
2026-10-29 Add settings page, ETA, replacement history, mDNS, pairing PIN
    - /settings: bed name, Wi-Fi (with async scan), mDNS host, pairing PIN,
    IV volumes and prescribed rate, stored in NVS (no reflash needed)
    - Estimated time left from prescribed or measured drip rate, shown on
    the monitor page and included in push messages
    - Per-bag history: usage time, alert-to-ack, alert-to-replacement
    - http://<host>.local via mDNS; hotspot mode keeps STA for scanning
    - Optional PIN for push pairing and settings, with lockout
    [SmartIVDrip.ino]
2026-10-30 Switch to buzzer module and WS2812B 8-LED strip
    Pixel 0 shows Wi-Fi status, pixels 1-7 form a level bar per state;
    blinking stops while muted. Buzzer trigger level is configurable for
    low-level-triggered modules.
    [SmartIVDrip.ino]
2026-10-30 Drive HW-508 passive buzzer with PWM tones
    Double beep for stage 1, two-tone siren for stage 2, low tone for
    sensor fault. Active modules still supported via BUZZER_PASSIVE.
    [SmartIVDrip.ino]
2026-10-30 Add wireless updates: ArduinoOTA and password-protected web update
    ota.ps1 compiles and uploads over Wi-Fi via /update; the LED strip shows
    progress during ArduinoOTA. OTA password lives in secrets.h.
2026-10-30 Add Chinese/English language switch to all pages
    Monitor, settings, pairing page and push app share a zh/en toggle that
    is remembered per browser and defaults to the phone language. Device
    error messages and push notification bodies are shown in English when
    English is selected (the service worker reads the saved language).
2026-10-30 Translate bed names and language button label in English mode
2026-11-13 Read TCRT5000 analog output with web calibration
    Sensors now use AO with smoothing, a calibrated midpoint and hysteresis.
    The settings page shows live readings and records wet/dry values, and
    warns when the difference is too small to be reliable.
    [SmartIVDrip.ino]
2026-11-13 Restore README emptied by a failed script; document AO wiring and calibration
2026-11-13 Calibrate upper and lower sensors separately
2026-11-13 Add ESP32-CAM level detection node and camera sensing mode
    IVCam estimates the fill level from row-brightness profiles against
    full/empty calibrations (log-ratio fit, robust to auto exposure) and
    serves a calibration page. The main controller can switch to camera
    mode, polls /level every second and maps percentages to the two stages;
    the monitor page shows the level percentage.
2026-11-13 Add printable striped background card for the camera node
2026-11-13 Add aluminium-foil capacitive sensing via ESP32 touch pins
    Sensing method 2 reads touchRead() on GPIO32/33 (T9/T8) with foil taped
    to the bag; calibration UI scales to the active sensor range and resets
    when switching between analog and touch.
    [SmartIVDrip.ino]
